CyberCityCircuits/Rupee-RGB-Earrings/Assets/RGB Ear Rings Front - Blue.png

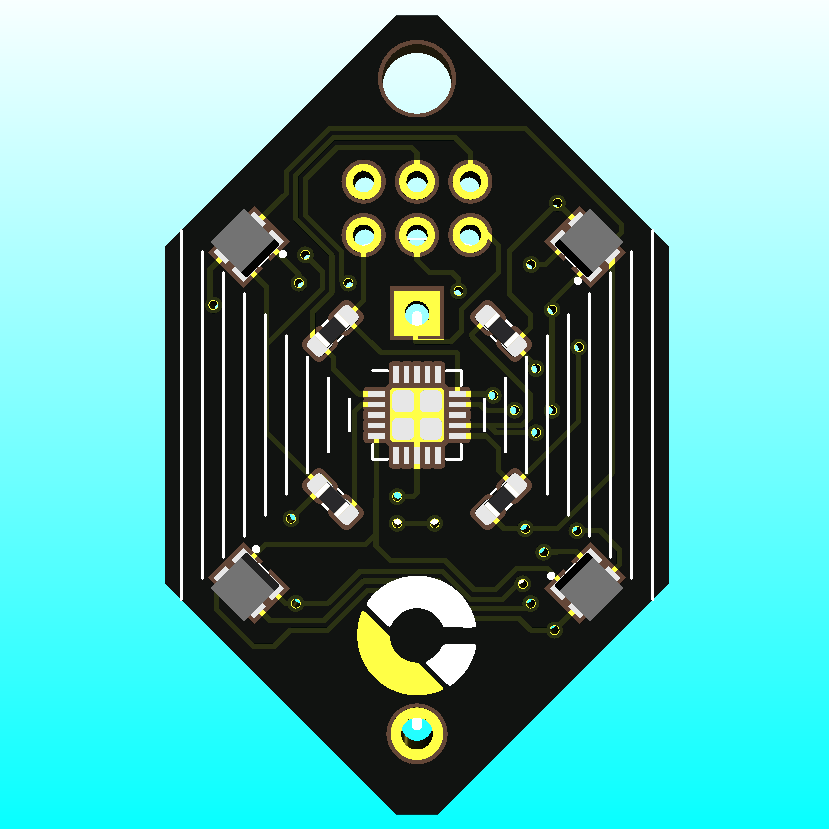
Assets/RGB Ear Rings Front - Blue.png
