CyberCityCircuits/Rupee-RGB-Earrings/Assets/Earrings 1_s.jpg

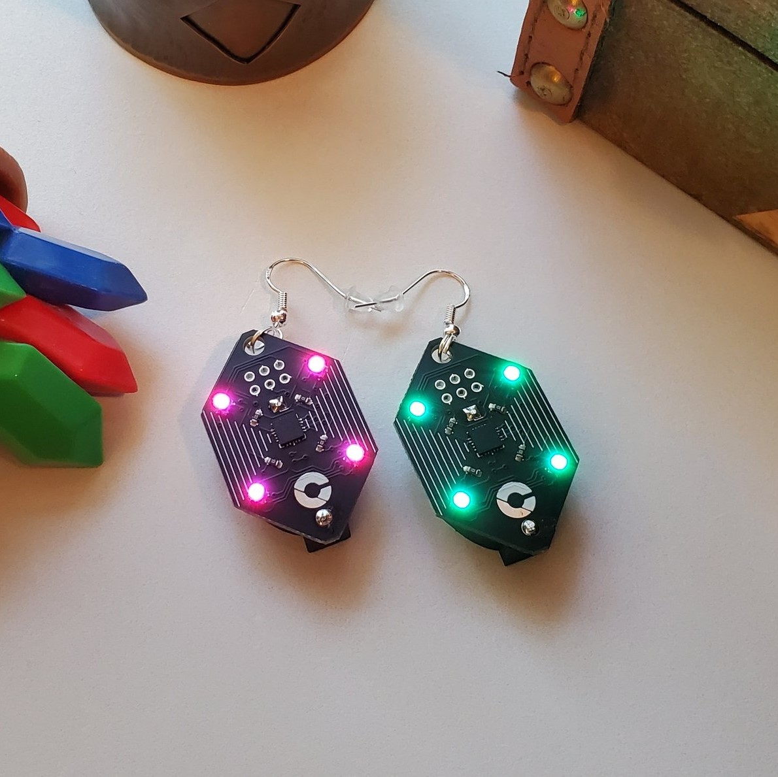
Assets/Earrings 1_s.jpg
