CyberCityCircuits/Rupee-RGB-Earrings/Assets/Earrings 2_s.jpg

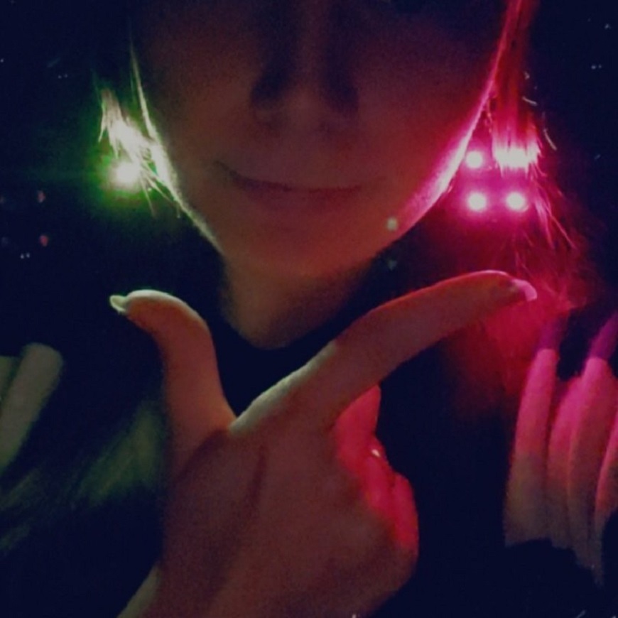
Assets/Earrings 2_s.jpg
