CyberCityCircuits/Rupee-RGB-Earrings/Assets/ICSP Header 1.PNG

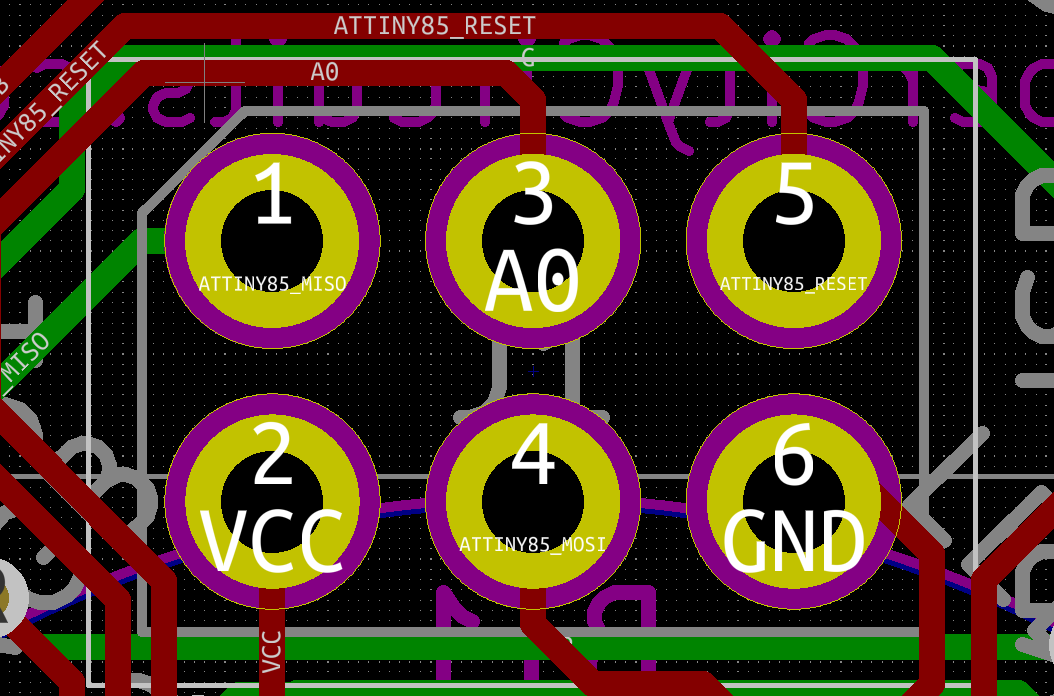
Assets/ICSP Header 1.PNG
