CyberCityCircuits/Rupee-RGB-Earrings/Assets/ICSP Header 2.PNG

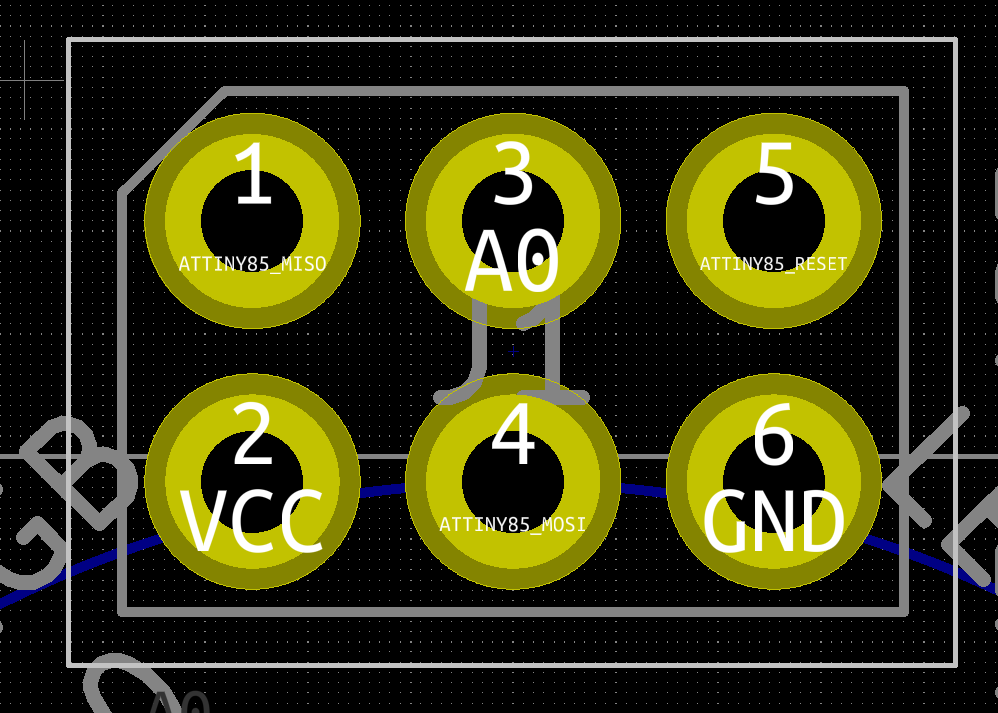
Assets/ICSP Header 2.PNG
