CyberCityCircuits/Rupee-RGB-Earrings/Assets/ICSP Header Annotated.PNG

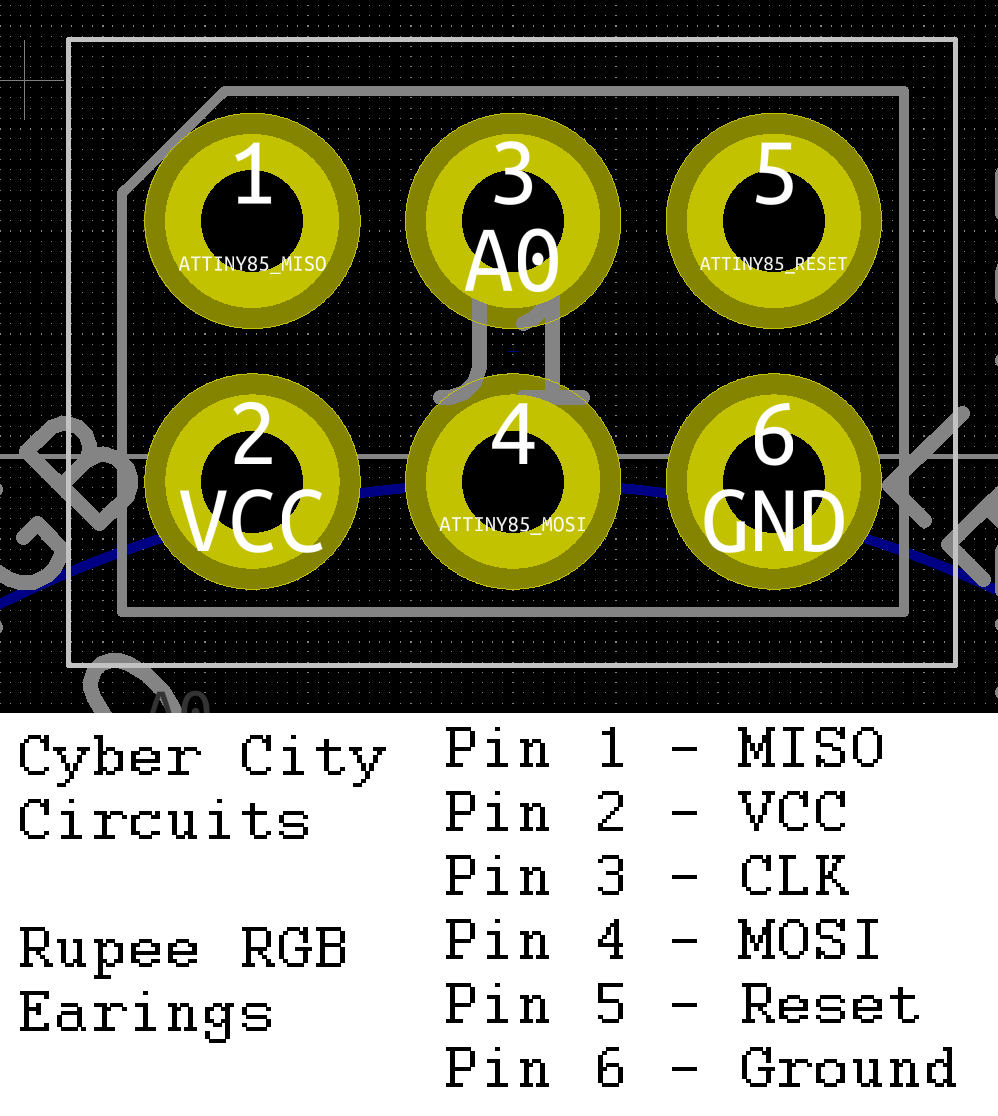
Assets/ICSP Header Annotated.PNG
