CyberCityCircuits/Rupee-RGB-Earrings/Assets/RGB Ear Rings Back.png

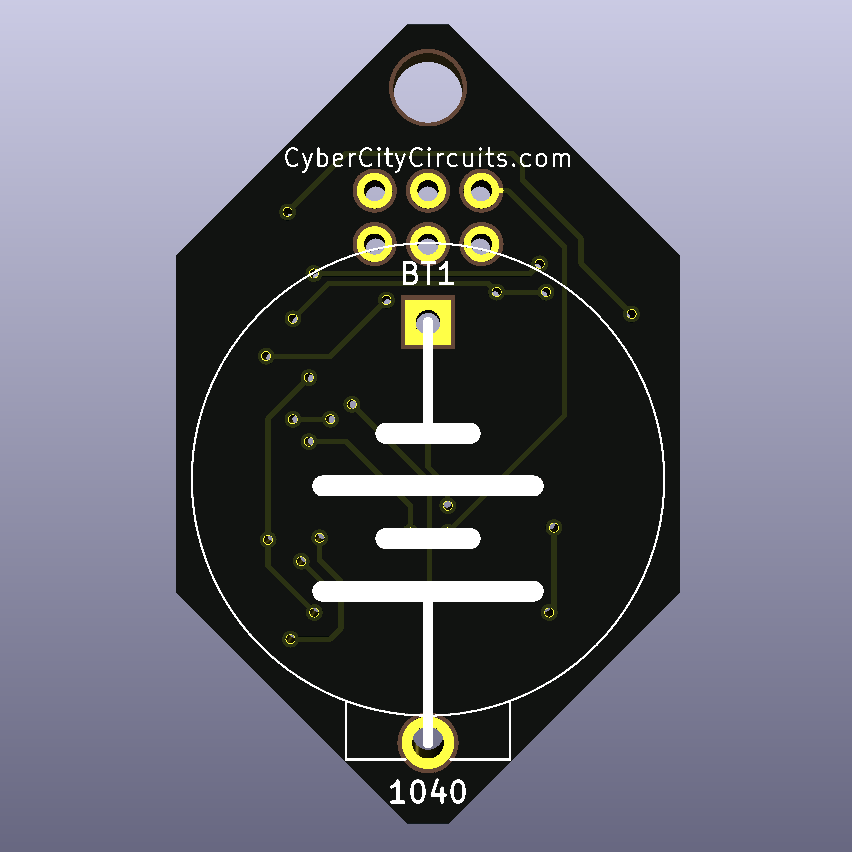
Assets/RGB Ear Rings Back.png
