CyberCityCircuits/Rupee-RGB-Earrings/Assets/RGB Ear Rings Front 02.png

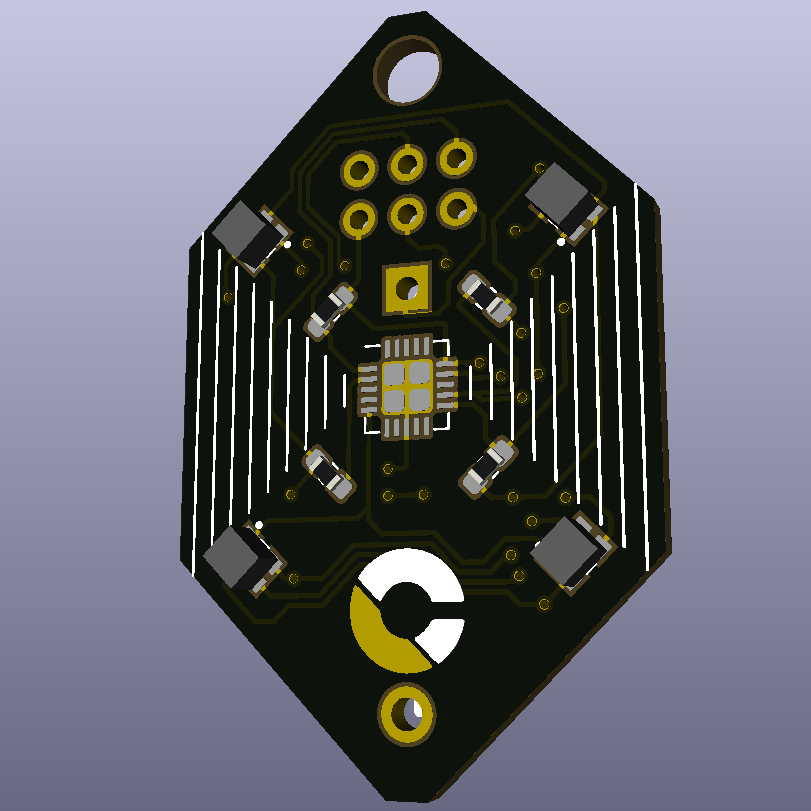
Assets/RGB Ear Rings Front 02.png
