CyberCityCircuits/Rupee-RGB-Earrings/Assets/Rupee-Animation.gif

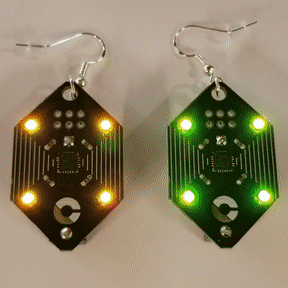
Assets/Rupee-Animation.gif
