CyberCityCircuits/Rupee-RGB-Earrings/Hardware/RGB Ear Rings BOM.xlsx

Designator | Item | Description | Footprint | Manufacturer | Part Number | Vendor | Vendor PN | Unit Cost
U1 | MCU | ATTING85V-15MT |  | Microchip | ATTINY85V-15MT | DigiKey | 1611-ATTINY85V-15MTCT-ND | 0.588 | 0.5
D1 | RGB LED |  | PLCC4 | Broadcom | ASMB-KTF0-0A306 | Mouser | 630-ASMB-KTF0-0A306 | 0.207 | 0.4
D2 | RGB LED |  | PLCC4 | Broadcom | ASMB-KTF0-0A306 | Mouser | 630-ASMB-KTF0-0A306 | 0.207 | 0.4
D3 | RGB LED |  | PLCC4 | Broadcom | ASMB-KTF0-0A306 | Mouser | 630-ASMB-KTF0-0A306 | 0.207 | 0.4
D4 | RGB LED |  | PLCC4 | Broadcom | ASMB-KTF0-0A306 | Mouser | 630-ASMB-KTF0-0A306 | 0.207 | 0.4
R1 | Resistor 0603 | 470 Ohm | 0603
R2 | Resistor 0603 | 470 Ohm | 0603
R3 | Resistor 0603 | 470 Ohm | 0603
R4 | Resistor 0603 | 10K Ohm | 0603
BT1 | Battery Holder
 | Battery
 | Earring Hooks
