CyberCityCircuits/Rupee-RGB-Earrings/Hardware/KiCAD Design/RGB Ear Ring.kicad_pcb

## KiCad design Hardware/KiCAD Design/RGB Ear Ring.kicad_pcb (2020-10-08)

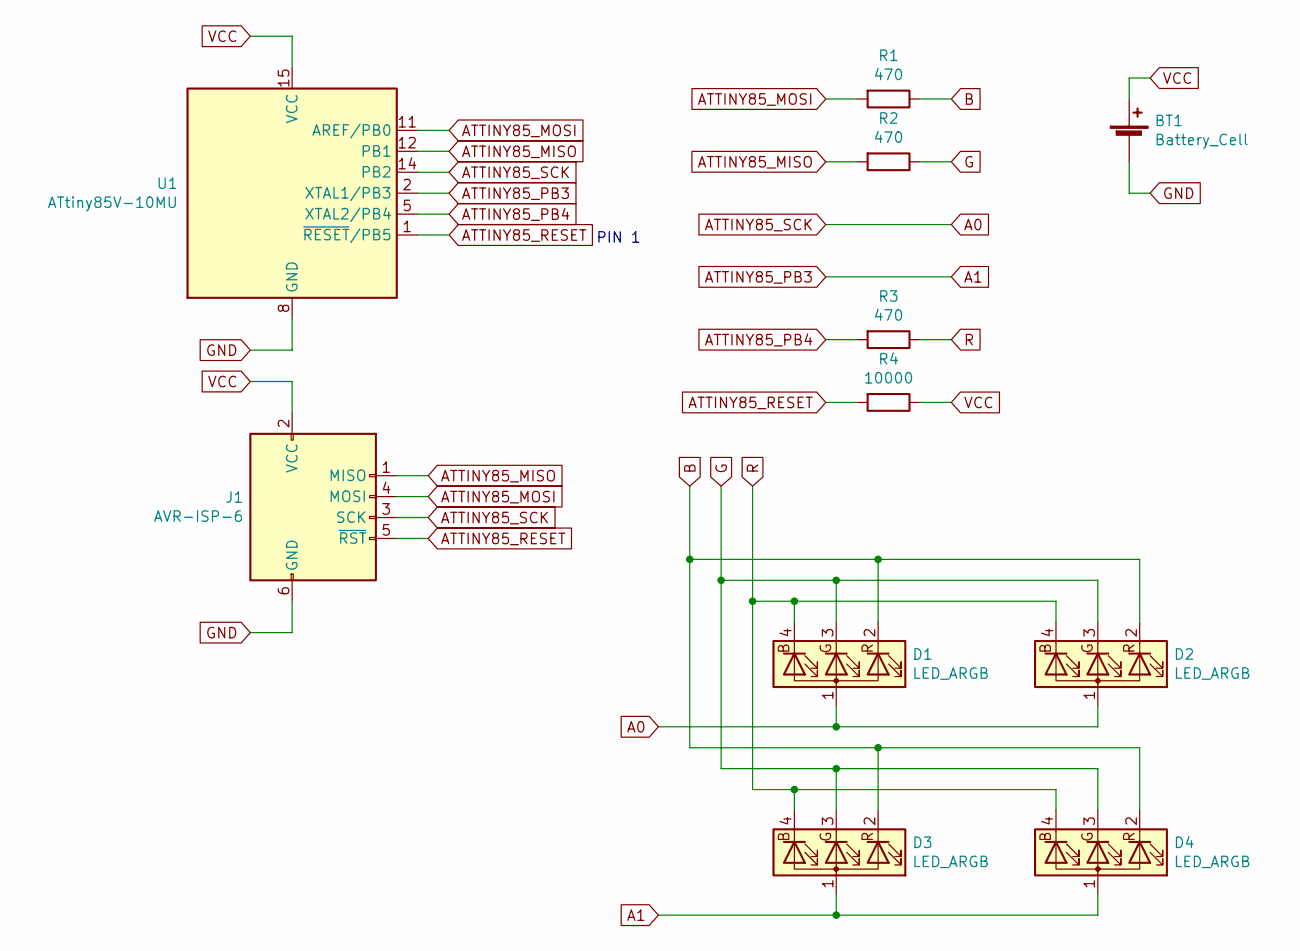
[picture p10: schematic RGB Ear Ring.sch]

Parts:
BT1: Battery_Cell; Schematic - Battery CR2032
D1, D2, D3, D4: LED_ARGB; LED_Cree-PLCC4_2x2mm_CW
J1: AVR-ISP-6; PinSocket_2x03_P2.54mm_Vertical
R1, R2, R3: 470; R_0603
R4: 10000; R_0603
U1: ATtiny85V-10MU; QFN-20-1EP_4x4mm_P0.5mm_EP2.6x2.6mm

Connections:
A0: D1.1 (A), D2.1 (A), J1.3 (SCK), U1.14 (PB2)
A1: D3.1 (A), D4.1 (A), U1.2 (XTAL1/PB3)
ATTINY85_MISO: J1.1 (MISO), R2.2, U1.12 (PB1)
ATTINY85_MOSI: J1.4 (MOSI), R1.2, U1.11 (AREF/PB0)
ATTINY85_PB4: R3.2, U1.5 (XTAL2/PB4)
ATTINY85_RESET: J1.5 (~RST), R4.2, U1.1 (~RESET~/PB5)
B: D1.2 (RK), D2.2 (RK), D3.2 (RK), D4.2 (RK), R1.1
G: D1.3 (GK), D2.3 (GK), D3.3 (GK), D4.3 (GK), R2.1
GND: BT1.2 (-), J1.6 (GND), U1.8 (GND), U1.21 (GND)
R: D1.4 (BK), D2.4 (BK), D3.4 (BK), D4.4 (BK), R3.1
VCC: BT1.1 (+), J1.2 (VCC), R4.1, U1.15 (VCC)

Notes on the sheet:
PIN 1

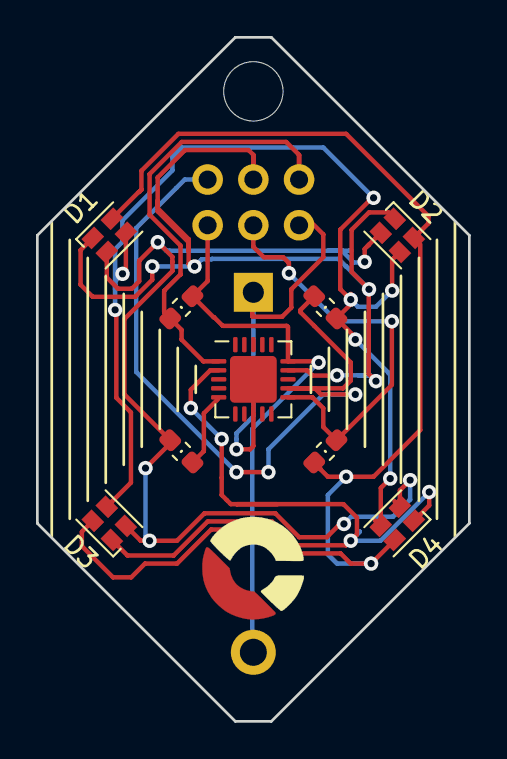
[picture p11: board RGB Ear Ring.kicad_pcb from above]

Board: 2 copper layers, 24.0 x 38.0 mm, 12 parts (1 on the bottom side), 11 nets.

Other parts of the board:
 : 3mm_Hole; 3mm Mount Hole
