CyberCityCircuits/Rupee-RGB-Earrings/(commit log)

2019-03-05 Added KiCAD files.
    Added KiCAD files.
    [001.kicad_pcb, 001.sch]
2020-10-02 Updated With All of the Deisgn Files
    [RGB Ear Ring.kicad_pcb, RGB Ear Ring.sch, RGB Ear Rings BOM.xlsx]
2020-10-08 Posted 1051 - (V2.1)
    Hardware Update for newer version. Allows for PWM function on Blue pins.
    [RGB Ear Ring.kicad_pcb, RGB Ear Ring.sch]
